nicholasshort/Tempting/PCB.jpg

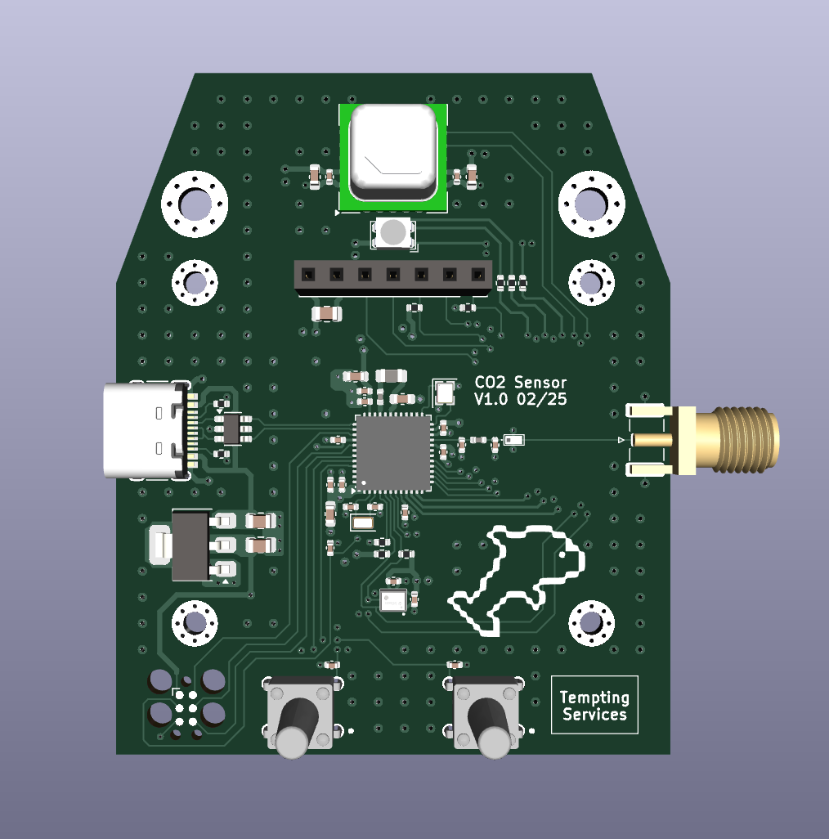
PCB.jpg
