nicholasshort/Tempting/Enclosure.jpg

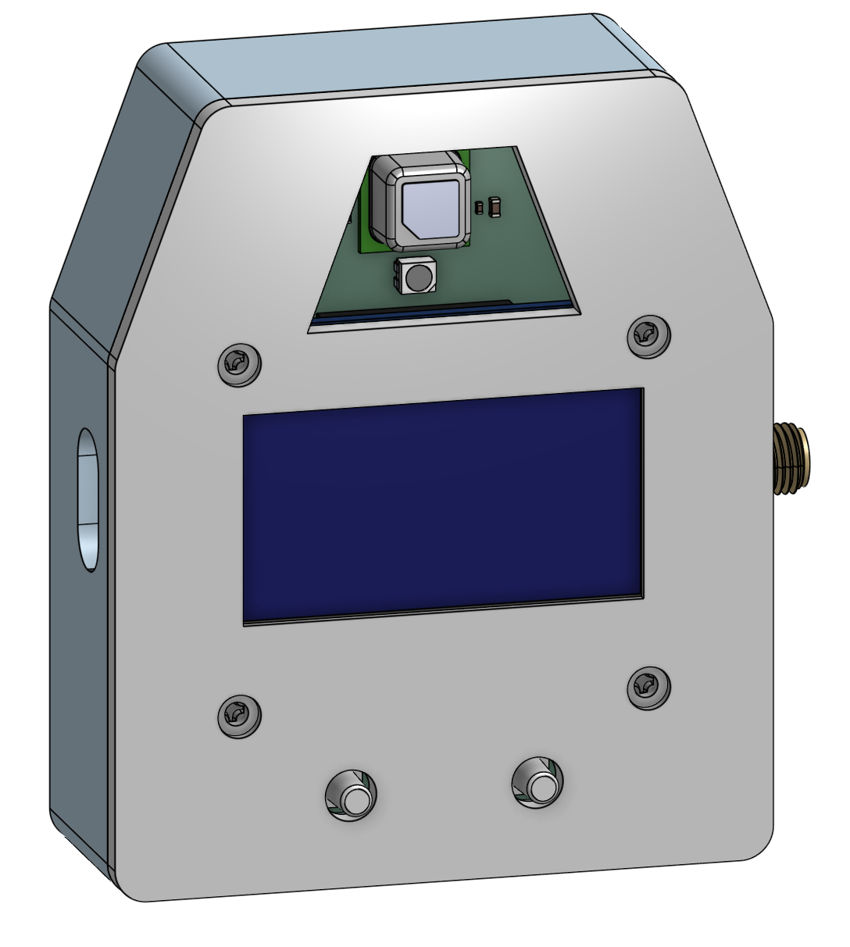
Enclosure.jpg
