nicholasshort/Tempting/TemptingPCB/Tempting.step

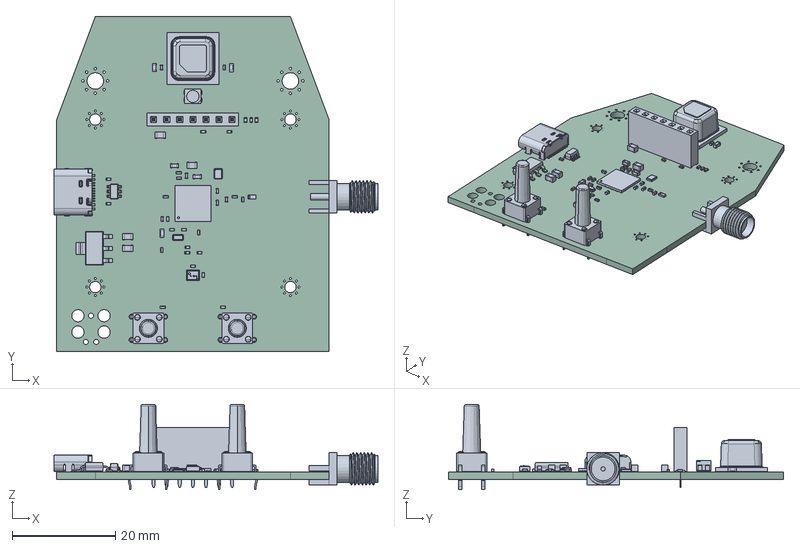
[picture p3: CAD file, 2025-06-16]
TemptingPCB/Tempting.step
62.8 x 65.0 x 16.5 mm
R_0402_1005Metric x 10
C_0402_1005Metric x 19
2-1825910-7-c-3d x 2
ConPins
PcbPins
Mold
Frame
C_0603_1608Metric x 5
SMA_Samtec_SMA-J-P-H-ST-EM1_EdgeMount
SCD41-D-R2
L_0402_1005Metric x 2
DLF162500LT-5028A1--3DModel-STEP-269445
SOT-23-6
PG-VLGA-8-2_Z8B00187549_V01_3D
L_0805_2012Metric
SOT-223
NX2012SA-32.768K-STD-MUB-1--3DModel-STEP-510211
PinSocket_1x07_P2.54mm_Vertical
CX2016DB32000D0WZRC1_CX2016DB32000D0WZRC1
C_0805_2012Metric x 3
STM32WB55CGU6
AAA3528LSEEZGKQBKS
Tempting_PCB
