nicholasshort/Tempting/TemptingPCB/Tempting_3D_Models/1_54inch-oled-module_sku25512.stp

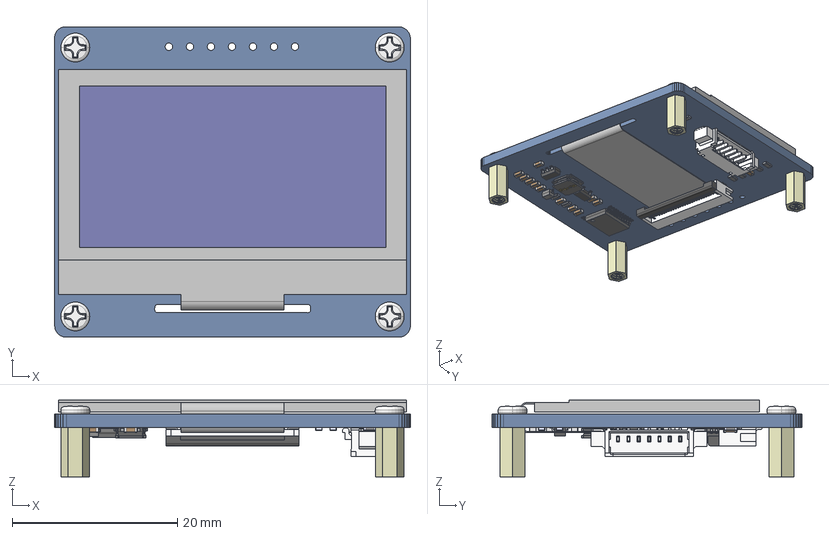
[picture p4: CAD file, 2025-05-03]
TemptingPCB/Tempting_3D_Models/1_54inch-oled-module_sku25512.stp
43.0 x 37.5 x 9.30 mm
BOARD
SW3DPS-SOT-23-5-DEFAULT x 2
USER_LIBRARY-TSSOP-20-2__-11558
USER_LIBRARY-TSSOP-20-2__-12509
USER_LIBRARY-TSSOP-20-2__-127_1 x 10
USER_LIBRARY-TSSOP-20-2__-127_2 x 10
RESC1608_0603_ x 8
HEADER-FPC-ZIF-SMD-HORIZO-17229
HEADER-FPC-ZIF-SMD-HORIZO-79148
USER_LIBRARY-INDLQS_4012_-80506
USER_LIBRARY-INDLQS_4012_-91143 x 2
USER_LIBRARY-INDLQS_4012_-91655
USER_LIBRARY-1N4148WS
CAPC1608_0603_ x 12
1_54INCH-128X64-QLED
HP1_25MM-1X7PIN-SMT
HEX_STUDS-M2XH6 x 4
PM2X5-SCREW x 4
