nicholasshort/Tempting/TemptingPCB/Tempting_3D_Models/HRO_TYPE-C-31-M-12.step

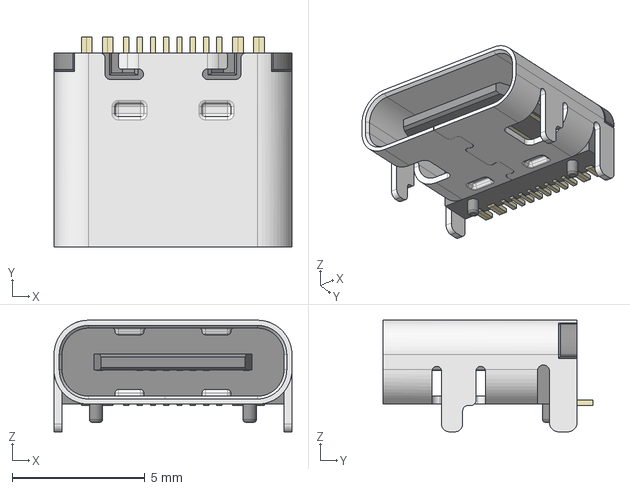
[picture p5: CAD file, 2025-02-19]
TemptingPCB/Tempting_3D_Models/HRO_TYPE-C-31-M-12.step
8.95 x 7.90 x 4.20 mm
