nicholasshort/Tempting/TemptingPCB/Tempting_3D_Models/SCD41-D-R2.STEP

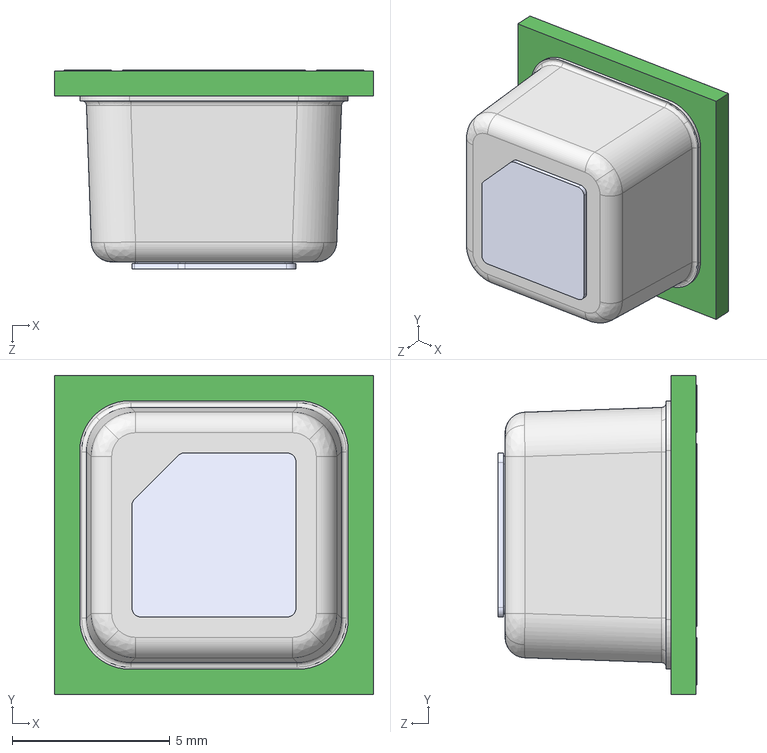
[picture p6: CAD file, 2025-02-19]
TemptingPCB/Tempting_3D_Models/SCD41-D-R2.STEP
10.1 x 10.1 x 6.31 mm
