nicholasshort/Tempting/TemptingPCB/Tempting_3D_Models/STM32WB55CGU6.step

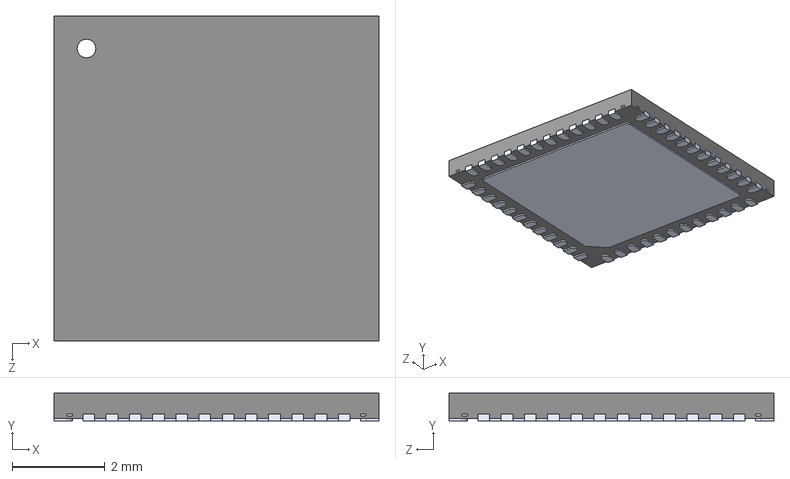
[picture p7: CAD file, 2025-02-19]
TemptingPCB/Tempting_3D_Models/STM32WB55CGU6.step
7.00 x 0.6 x 7.00 mm
