nicholasshort/Tempting/TemptingPCB/Tempting_3D_Models/AAA3528LSEEZGKQBKS.step

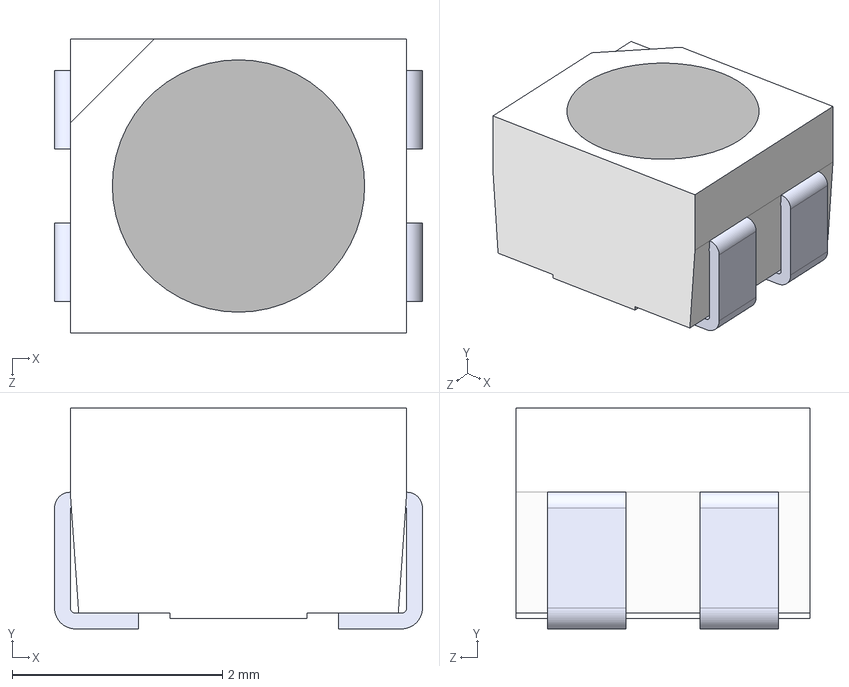
[picture p8: CAD file, 2025-02-19]
TemptingPCB/Tempting_3D_Models/AAA3528LSEEZGKQBKS.step
3.50 x 2.10 x 2.80 mm
