nicholasshort/Tempting/TemptingPCB/Tempting_3D_Models/CX2016DB16000D0WZRC1.STEP

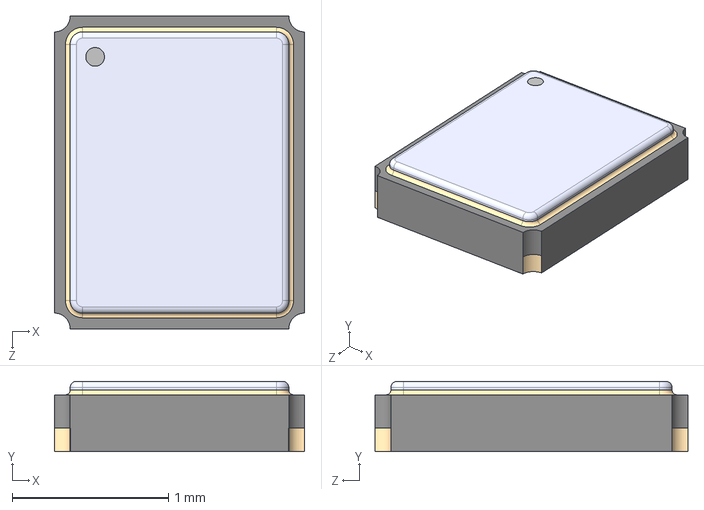
[picture p9: CAD file, 2025-02-19]
TemptingPCB/Tempting_3D_Models/CX2016DB16000D0WZRC1.STEP
1.60 x 0.45 x 2.00 mm
