nicholasshort/Tempting/TemptingPCB/Tempting_3D_Models/PG-VLGA-8-2_Z8B00187549_V01_3D.stp

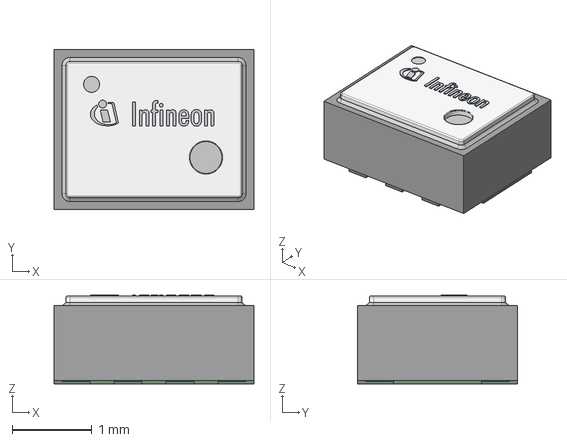
[picture p10: CAD file, 2025-02-19]
TemptingPCB/Tempting_3D_Models/PG-VLGA-8-2_Z8B00187549_V01_3D.stp
2.50 x 2.00 x 1.11 mm
