nicholasshort/Tempting/TemptingPCB/Tempting_3D_Models/2-1825910-7-c-3d.stp

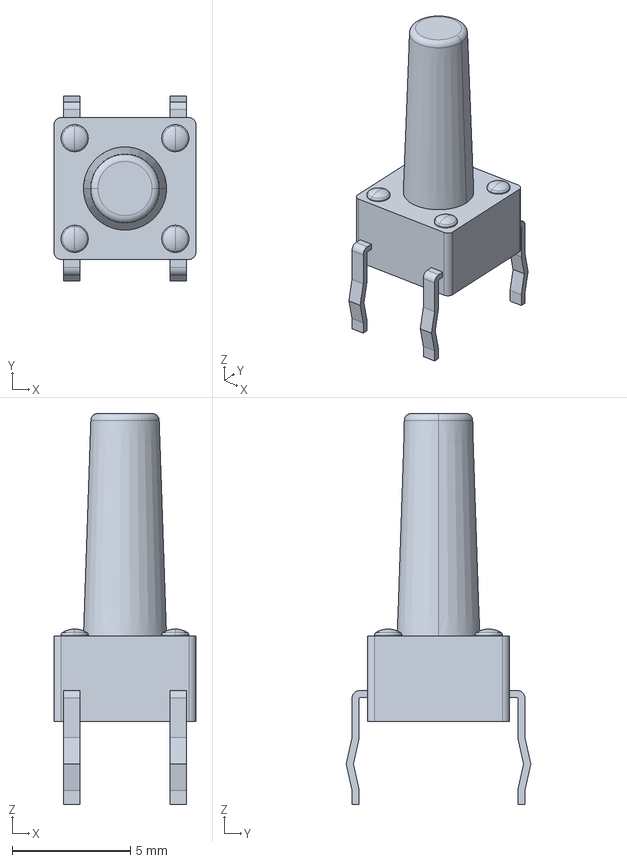
[picture p11: CAD file, 2025-02-19]
TemptingPCB/Tempting_3D_Models/2-1825910-7-c-3d.stp
5.99 x 7.80 x 16.5 mm
