nicholasshort/Tempting/TemptingPCB/Tempting_3D_Models/NX2012SA-32.768K-STD-MUB-1--3DModel-STEP-510211.STEP

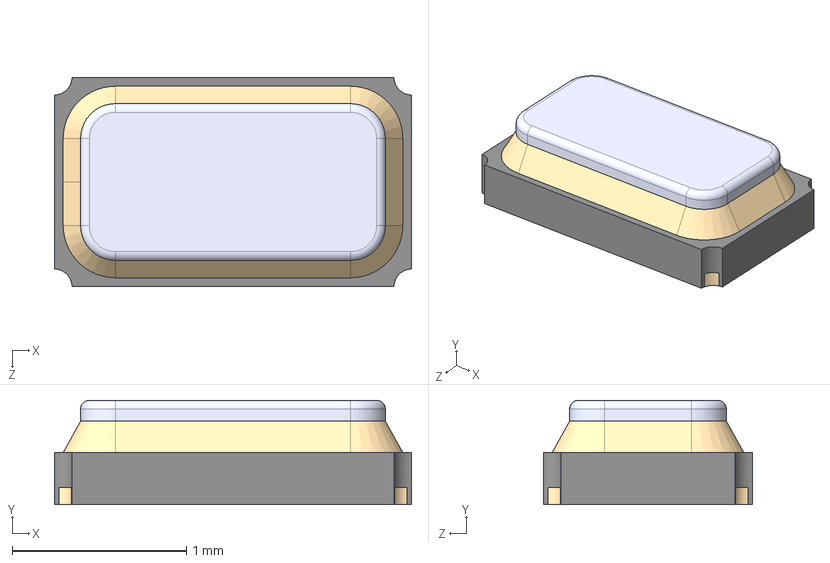
[picture p12: CAD file, 2025-02-19]
TemptingPCB/Tempting_3D_Models/NX2012SA-32.768K-STD-MUB-1--3DModel-STEP-510211.STEP
2.05 x 0.6 x 1.20 mm
