nicholasshort/Tempting/TemptingPCB/Tempting_3D_Models/DLF162500LT-5028A1--3DModel-STEP-269445.STEP

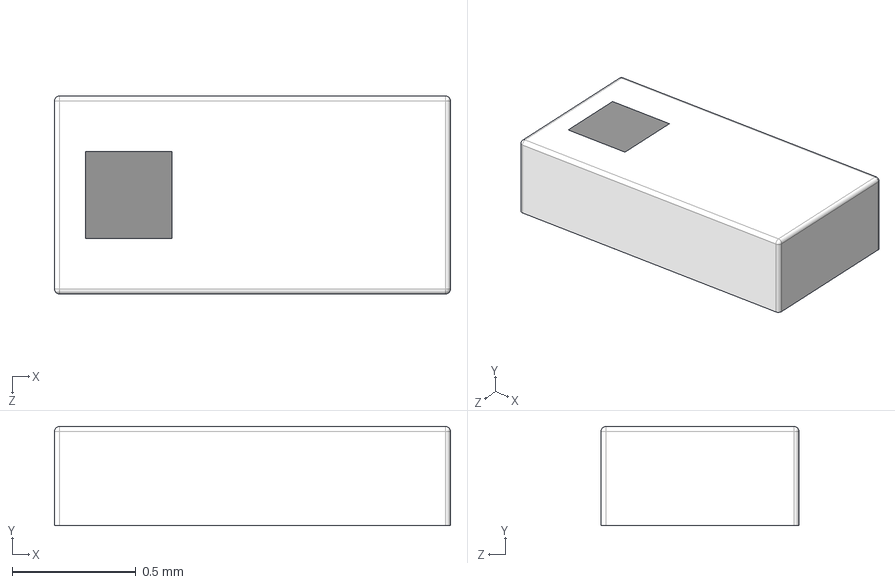
[picture p13: CAD file, 2025-02-19]
TemptingPCB/Tempting_3D_Models/DLF162500LT-5028A1--3DModel-STEP-269445.STEP
1.60 x 0.4 x 0.8 mm
