nicholasshort/Tempting/TemptingPCB/Tempting.kicad_pcb

## KiCad design TemptingPCB/Tempting.kicad_pcb (2025-02-28)

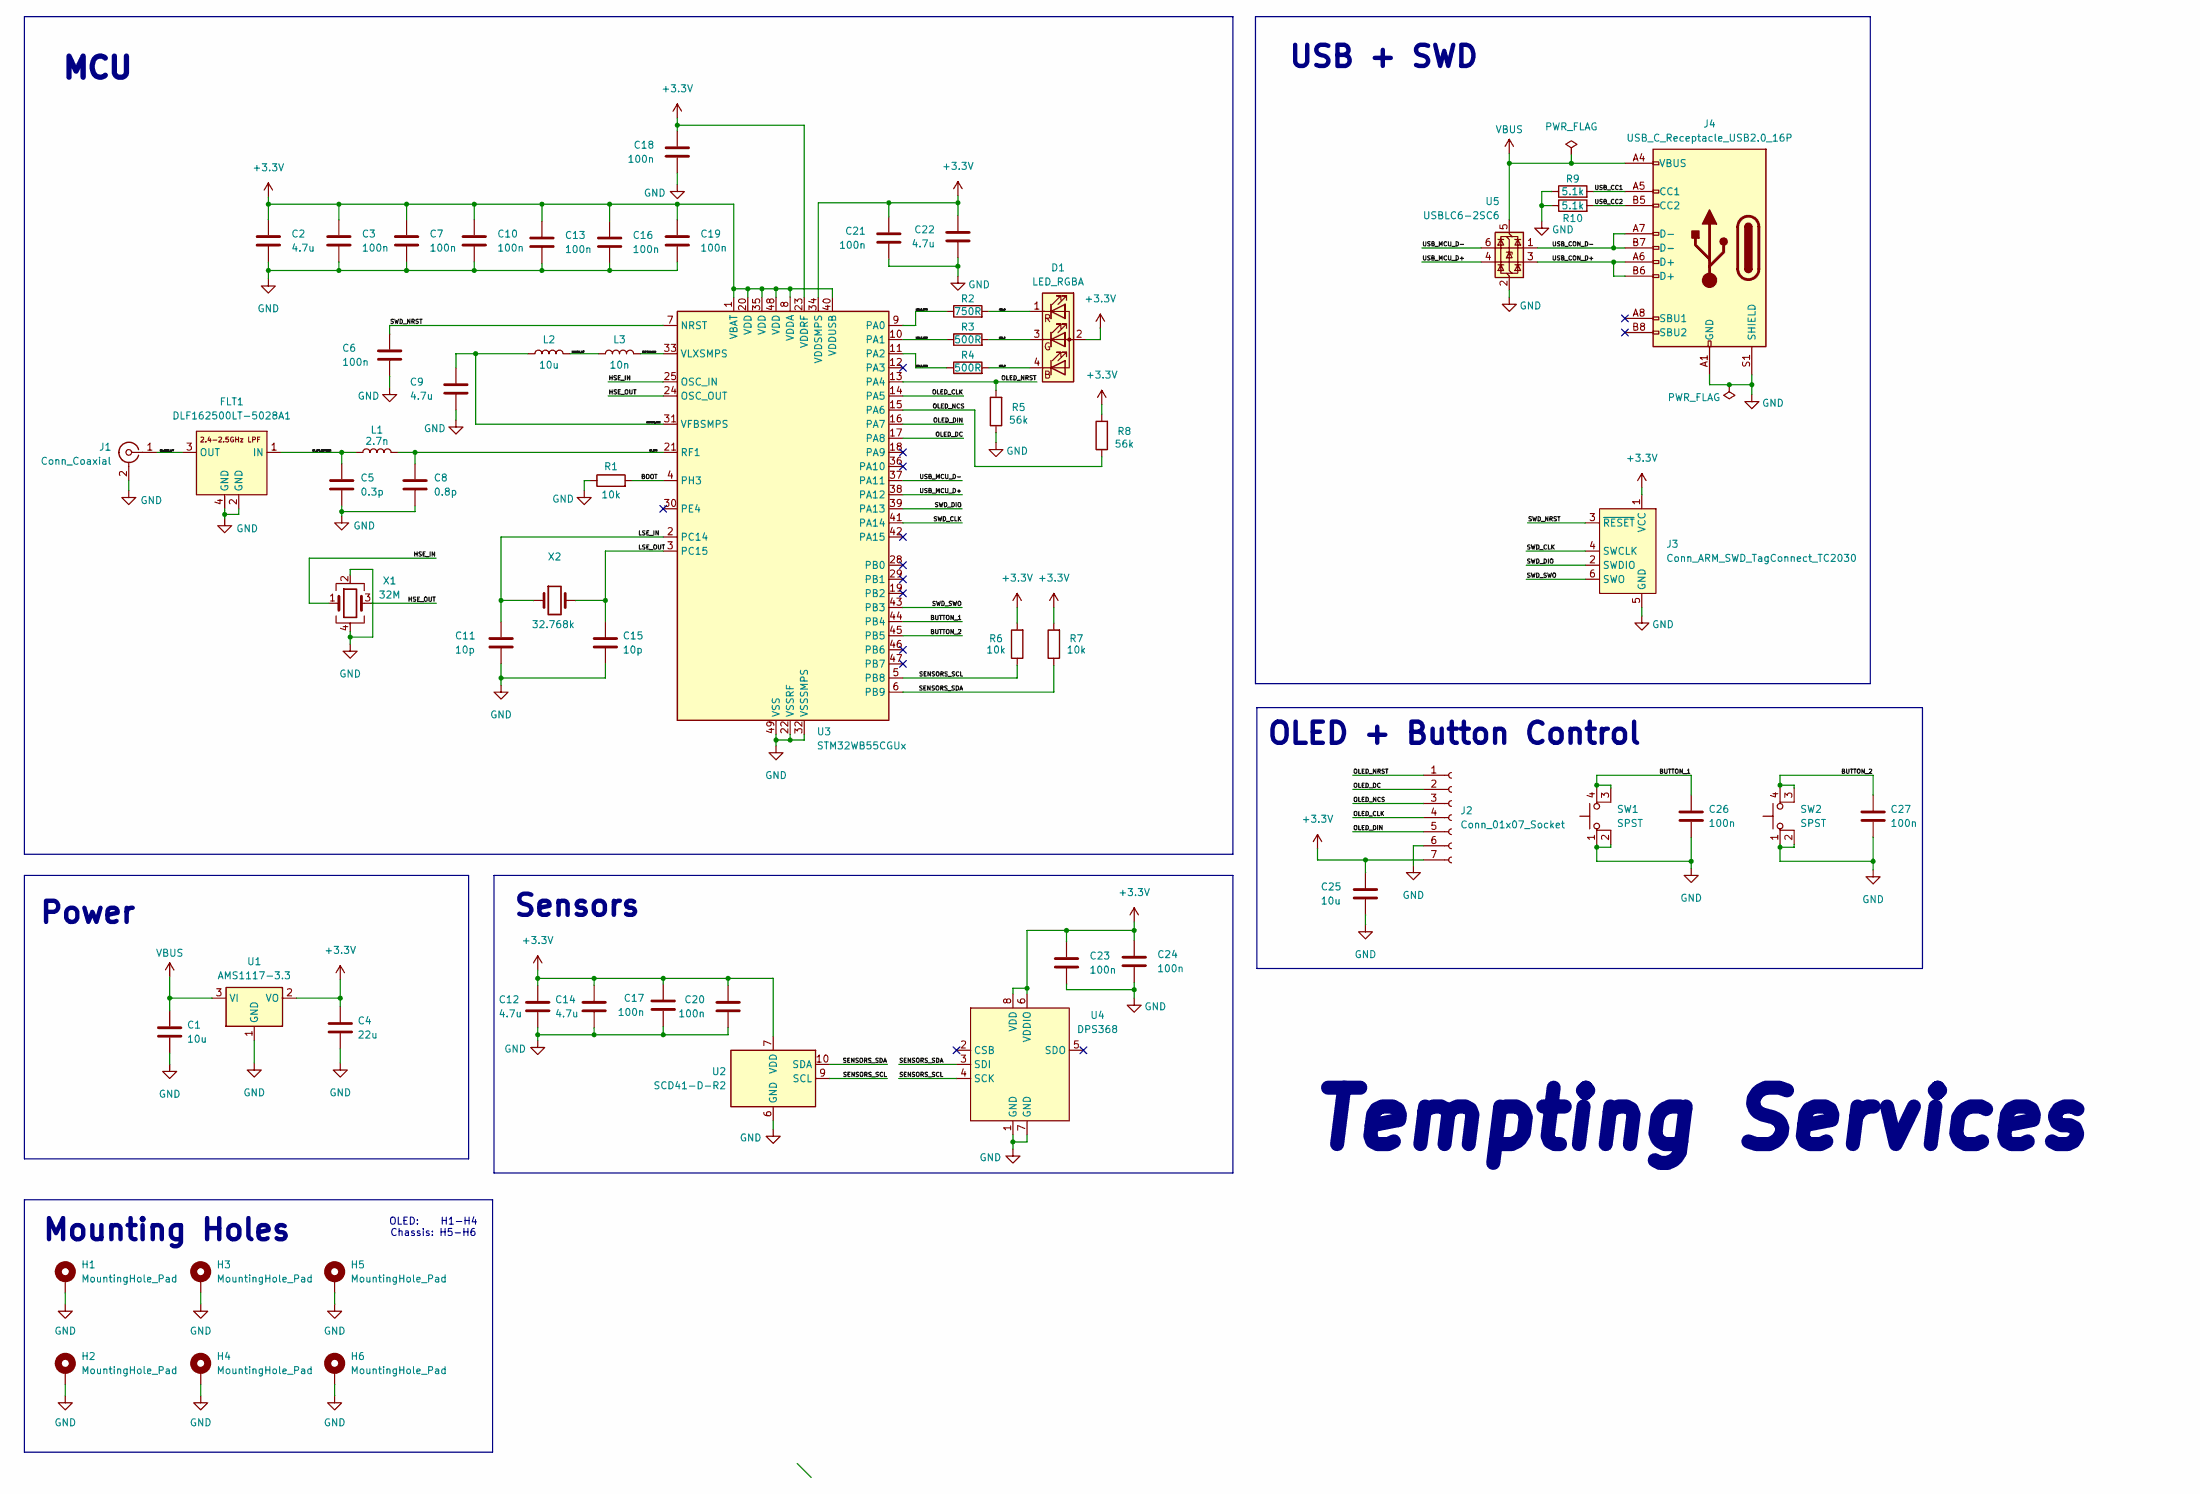
[picture p14: schematic Tempting.kicad_sch]

Parts:
C1, C25: 10u; C_0805_2012Metric; JLCPCB Part # C15850
C2, C9, C12, C14, C22: 4.7u; C_0603_1608Metric; JLCPCB Part # C1705
C3, C6, C7, C10, C13, C16, C17, C18, C19, C20, C21, C23, C24, C26, C27: 100n; C_0402_1005Metric; JLCPCB Part # C1525
C4: 22u; C_0805_2012Metric; JLCPCB Part # C29277
C5: 0.3p; C_0402_1005Metric; JLCPCB Part # C880415
C8: 0.8p; C_0402_1005Metric; JLCPCB Part # C76915
C11, C15: 10p; C_0402_1005Metric; JLCPCB Part # C161145
D1: LED_RGBA; AAA3528LSEEZGKQBKS; JLCPCB Part # C5547384
FLT1: DLF162500LT-5028A1; JLCPCB Part # C531364
H1, H2, H3, H4: MountingHole_Pad; MountingHole_2.2mm_M2_Pad_Via
H5, H6: MountingHole_Pad; MountingHole_3.2mm_M3_Pad_Via
J1: Conn_Coaxial; SMA_Samtec_SMA-J-P-H-ST-EM1_EdgeMount; JLCPCB Part # C5199907
J2: Conn_01x07_Socket; PinSocket_1x07_P2.54mm_Vertical
J3: Conn_ARM_SWD_TagConnect_TC2030; Tag-Connect_TC2030-IDC-FP_2x03_P1.27mm_Vertical
J4: USB_C_Receptacle_USB2.0_16P; USB_C_Receptacle_HRO_TYPE-C-31-M-12; JLCPCB Part # C165948
L1: 2.7n; L_0402_1005Metric; JLCPCB Part # C77108
L2: 10u; L_0805_2012Metric; JLCPCB Part # C98030
L3: 10n; L_0402_1005Metric; JLCPCB Part # C76760
R1, R6, R7: 10k; R_0402_1005Metric; JLCPCB Part # C25744
R2: 750R; R_0402_1005Metric; JLCPCB Part # C25132
R3, R4: 500R; R_0402_1005Metric; JLCPCB Part # C4125
R5, R8: 56k; R_0402_1005Metric; JLCPCB Part # C25796
R9, R10: 5.1k; R_0402_1005Metric; JLCPCB Part # C25905
SW1, SW2: SPST; 2-1825910-7; JLCPCB Part # C513492
U1: AMS1117-3.3; SOT-223-3_TabPin2; JLCPCB Part # C6186
U2: SCD41-D-R2; Sensirion_SCD4x-1EP_10.1x10.1mm_P1.25mm_EP4.8x4.8mm; JLCPCB Part # C3659362
U3: STM32WB55CGUx; QFN-48-1EP_7x7mm_P0.5mm_EP5.6x5.6mm; JLCPCB Part # C404023
U4: DPS368; JLCPCB Part # C3232508
U5: USBLC6-2SC6; SOT-23-6; JLCPCB Part # C7519
X1: 32M; Crystal_SMD_2016-4Pin_2.0x1.6mm; JLCPCB Part # C1986260
X2: 32.768k; Crystal_SMD_2012-2Pin_2.0x1.2mm; JLCPCB Part # C528982

Connections:
+3.3V: C2.1, C3.1, C4.1, C7.1, C10.1, C12.1, C13.1, C14.1, C16.1, C17.1, C18.1, C19.1, C20.1, C21.1, C22.1, C23.1, C24.1, C25.1, D1.2 (A), J2.7, J3.1 (VCC), R6.2, R7.2, R8.2, U1.2 (VO), U2.7 (VDD), U2.19 (VDD), U3.1 (VBAT), U3.8 (VDDA), U3.20 (VDD), U3.23 (VDDRF), U3.34 (VDDSMPS), U3.35 (VDD), U3.40 (VDDUSB), U3.48 (VDD), U4.6 (VDDIO), U4.8 (VDD)
/BOOT: R1.2, U3.4 (PH3)
/BUTTON_1: C26.1, SW1.3 (K), SW1.4 (A), U3.44 (PB4)
/BUTTON_2: C27.1, SW2.3 (K), SW2.4 (A), U3.45 (PB5)
/HSE_IN: U3.25 (OSC_IN), X1.1
/HSE_OUT: U3.24 (OSC_OUT), X1.3
/LED_B: D1.4 (BK), R4.2
/LED_B_MCU: R4.1, U3.11 (PA2)
/LED_G: D1.3 (GK), R3.2
/LED_G_MCU: R3.1, U3.10 (PA1)
/LED_R: D1.1 (RK), R2.2
/LED_R_MCU: R2.1, U3.9 (PA0)
/LSE_IN: C11.1, U3.2 (PC14), X2.1
/LSE_OUT: C15.1, U3.3 (PC15), X2.2
/OLED_CLK: J2.4, U3.14 (PA5)
/OLED_DC: J2.2, U3.17 (PA8)
/OLED_DIN: J2.5, U3.16 (PA7)
/OLED_NCS: J2.3, R8.1, U3.15 (PA6)
/OLED_NRST: J2.1, R5.2, U3.13 (PA4)
/RF_COAX_LPF: FLT1.3 (OUT), J1.1 (In)
/RF_LPF_MATCHING: C5.1, FLT1.1 (IN), L1.1
/RF_MCU: C8.1, L1.2, U3.21 (RF1)
/SENSORS_SCL: R6.1, U2.9 (SCL), U3.5 (PB8), U4.4 (SCK)
/SENSORS_SDA: R7.1, U2.10 (SDA), U3.6 (PB9), U4.3 (SDI)
/SMPSFB_MCU: C9.1, L2.1, U3.31 (VFBSMPS)
/SMPSLX_INT: L2.2, L3.1
/SMPSLX_MCU: L3.2, U3.33 (VLXSMPS)
/SWD_CLK: J3.4 (SWCLK), U3.41 (PA14)
/SWD_DIO: J3.2 (SWDIO), U3.39 (PA13)
/SWD_NRST: C6.1, J3.3 (~RESET), U3.7 (NRST)
/SWD_SWO: J3.6 (SWO), U3.43 (PB3)
/USB_CC1: J4.A5 (CC1), R9.2
/USB_CC2: J4.B5 (CC2), R10.2
/USB_CON_D+: J4.A6 (D+), J4.B6 (D+), U5.3 (I/O2)
/USB_CON_D-: J4.A7 (D-), J4.B7 (D-), U5.1 (I/O1)
/USB_MCU_D+: U3.38 (PA12), U5.4 (I/O2)
/USB_MCU_D-: U3.37 (PA11), U5.6 (I/O1)
GND: C1.2, C2.2, C3.2, C4.2, C5.2, C6.2, C7.2, C8.2, C9.2, C10.2, C11.2, C12.2, C13.2, C14.2, C15.2, C16.2, C17.2, C18.2, C19.2, C20.2, C21.2, C22.2, C23.2, C24.2, C25.2, C26.2, C27.2, FLT1.2 (GND), FLT1.4 (GND), H1.1, H2.1, H3.1, H4.1, H5.1, H6.1, J1.2 (Ext), J2.6, J3.5 (GND), J4.A1 (GND), J4.A12 (GND), J4.B1 (GND), J4.B12 (GND), J4.S1 (SHIELD), R1.1, R5.1, R9.1, R10.1, SW1.1, SW1.2, SW2.1, SW2.2, U1.1 (GND), U2.6 (GND), U2.20 (GND), U2.21 (GND), U3.22 (VSSRF), U3.32 (VSSSMPS), U3.49 (VSS), U4.1 (GND), U4.7 (GND), U5.2 (GND), X1.2, X1.4
VBUS: C1.1, J4.A4 (VBUS), J4.A9 (VBUS), J4.B4 (VBUS), J4.B9 (VBUS), U1.3 (VI), U5.5 (VBUS)

Notes on the sheet:
Tempting Services
MCU
USB + SWD
Mounting Holes
Power
Sensors
OLED + Button Control
OLED: H1-H4 Chassis: H5-H6

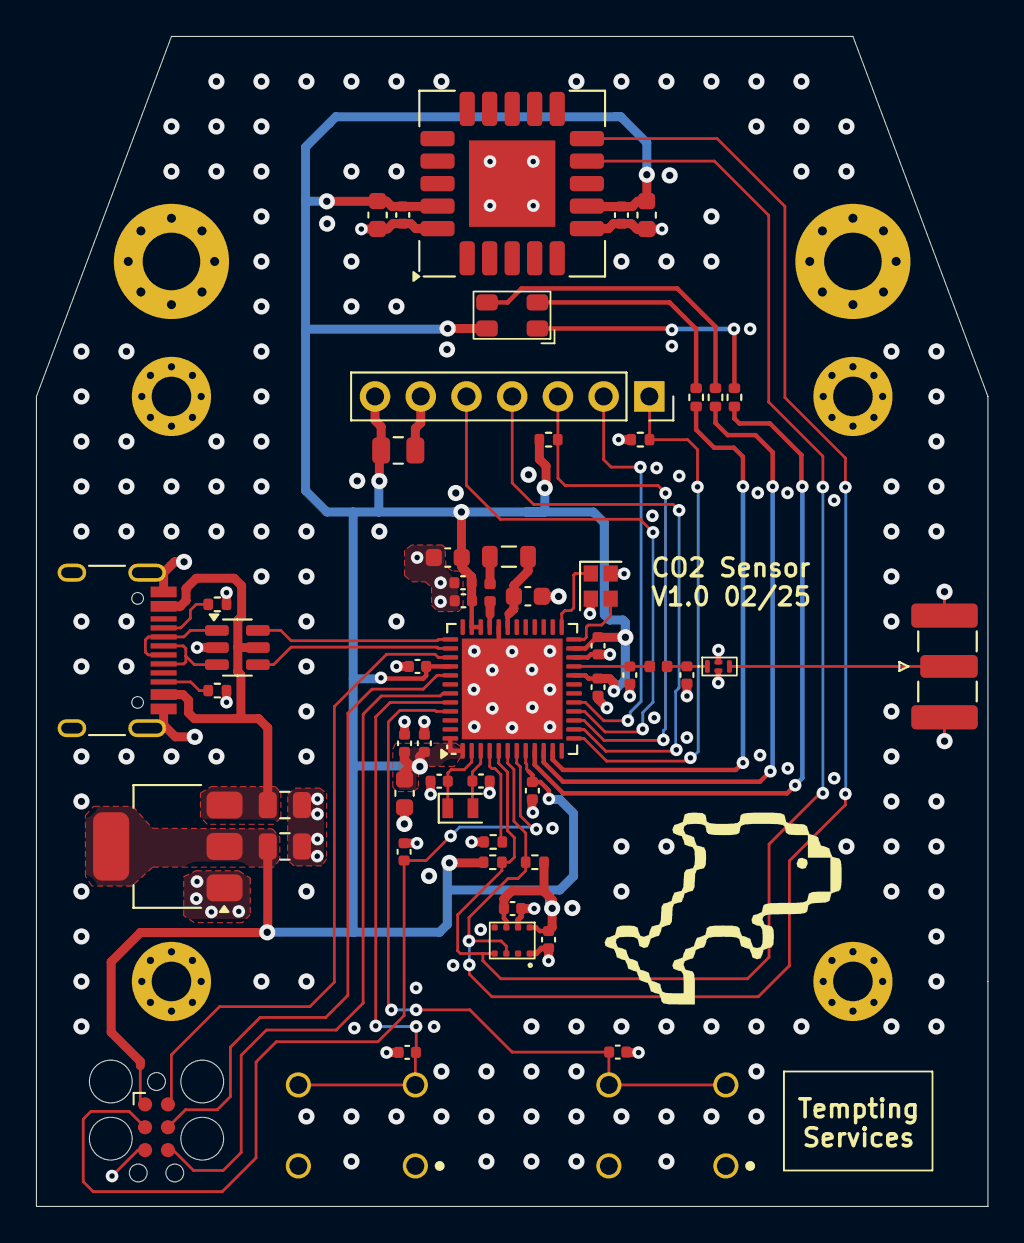
[picture p15: board Tempting.kicad_pcb from above]

Board: 4 copper layers, 52.9 x 65.0 mm, 61 parts (0 on the bottom side), 39 nets.
