nicholasshort/Tempting/TemptingFirmware/Core/Src/main.c

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
/* Includes ------------------------------------------------------------------*/
#include "main.h"
#include "i2c.h"
#include "ipcc.h"
#include "memorymap.h"
#include "rf.h"
#include "rtc.h"
#include "spi.h"
#include "tim.h"
#include "usb_device.h"
#include "gpio.h"

/* USER CODE BEGIN Includes */
#include "DPS368-Barometer.h"
#include "SCD41-CO2Sensor.h"
#include "SSD1309-OLED.h"
#include "RGB_LED.h"
#include "usbd_cdc_if.h"
/* USER CODE END Includes */


void SystemClock_Config(void);
void PeriphCommonClock_Config(void);
/* USER CODE BEGIN 0 */
int _write(int file, char *ptr, int len)
{
    while (CDC_Transmit_FS((uint8_t *)ptr, len) == USBD_BUSY) {
        // Optional: delay or yield to avoid USB deadlock
    }
    return len;
}
/* USER CODE END 0 */

/**
  * @brief  The application entry point.
  * @retval int
  */
int main(void)
{

  /* MCU Configuration--------------------------------------------------------*/

  /* Reset of all peripherals, Initializes the Flash interface and the Systick. */
  HAL_Init();
  /* Config code for STM32_WPAN (HSE Tuning must be done before system clock configuration) */
  MX_APPE_Config();

  /* Configure the system clock */
  SystemClock_Config();

  /* Configure the peripherals common clocks */
  PeriphCommonClock_Config();

  /* IPCC initialisation */
  MX_IPCC_Init();

  /* Initialize all configured peripherals */
  MX_GPIO_Init();
  MX_I2C1_Init();
  MX_SPI1_Init();
  MX_TIM2_Init();
  MX_RTC_Init();
  MX_USB_Device_Init();
  MX_RF_Init();
  /* USER CODE BEGIN 2 */
  RGB_LED_Init();
  RGB_LED_Set_Intensity(RGB_LED_RED_MAX_INTENSITY,0,0);

  DPS368_Init();
  SSD1309_Init();
  SCD41_StopPeriodicMeasurement();
  SCD41_StartPeriodicMeasurement();
  /* USER CODE END 2 */

  /* Init code for STM32_WPAN */
  MX_APPE_Init();

  /* Infinite loop */
  /* USER CODE BEGIN WHILE */

  while (1)
  {
    /* USER CODE END WHILE */
    MX_APPE_Process();

    /* USER CODE BEGIN 3 */
  }
  /* USER CODE END 3 */
}

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
