nicholasshort/Tempting/TemptingFirmware/TemptingFirmware.ioc

Mcu.UserName=STM32WB55CGUx
PA0.Signal=S_TIM2_CH1
PA1.Signal=S_TIM2_CH2
PA11.Signal=USB_DM
PA12.Signal=USB_DP
PA13.Signal=SYS_JTMS-SWDIO
PA14.Signal=SYS_JTCK-SWCLK
PA2.Signal=S_TIM2_CH3
PA4.GPIO_Label=OLED_NRST
PA4.Signal=GPIO_Output
PA5.Signal=SPI1_SCK
PA6.GPIO_Label=OLED_NCS
PA6.Signal=GPIO_Output
PA7.Signal=SPI1_MOSI
PA8.GPIO_Label=OLED_DC
PA8.Signal=GPIO_Output
PB3.Signal=SYS_JTDO-SWO
PB4.Signal=GPXTI4
PB5.Signal=GPXTI5
PB8.Signal=I2C1_SCL
PB9.Signal=I2C1_SDA
PC14-OSC32_IN.Signal=RCC_OSC32_IN
PC15-OSC32_OUT.Signal=RCC_OSC32_OUT
