nicholasshort/Tempting/TemptingFirmware/Core/Inc/main.h

#define OLED_NRST_Pin GPIO_PIN_4
#define OLED_NRST_GPIO_Port GPIOA
#define OLED_NCS_Pin GPIO_PIN_6
#define OLED_NCS_GPIO_Port GPIOA
#define OLED_DC_Pin GPIO_PIN_8
#define OLED_DC_GPIO_Port GPIOA
