nicholasshort/Tempting/(commit log)

2025-02-05 Added gitignore
    [Tempting.kicad_pcb, Tempting.kicad_sch]
2025-02-05 Added decouplign capacitors to schematic
    [Tempting.kicad_sch]
2025-02-05 Added crystals
    [Tempting.kicad_sch]
2025-02-07 Added RF circuitry to schematic
    [Tempting.kicad_sch]
2025-02-07 Added USB connector
    [Tempting.kicad_sch]
2025-02-07 Added LDO
    [Tempting.kicad_sch]
2025-02-07 Added OLED comm pins
    [Tempting.kicad_sch]
2025-02-07 Added circuitry for SCD41
    [Tempting.kicad_sch]
2025-02-12 Created symbol and footprint for DPS368
2025-02-12 Cleaned up and finished schematic
    [Tempting.kicad_sch]
2025-02-13 Added new footprints and assigned all footprints
    [Tempting.kicad_sch]
2025-02-13 Added all missing 3D models
    [Tempting.kicad_pcb]
2025-02-13 Added net classes
    [Tempting.kicad_pcb]
2025-02-13 Rough initial layout
    [Tempting.kicad_pcb, Tempting.kicad_sch]
2025-02-18 Added edge cuts and mounting holes
    [Tempting.kicad_pcb, Tempting.kicad_sch]
2025-02-18 Finetuned layout
    [Tempting.kicad_pcb, Tempting.kicad_sch]
2025-02-18 All signal traces routed
    [Tempting.kicad_pcb, Tempting.kicad_sch]
2025-02-19 Fixed DRC violations
    [Tempting.kicad_pcb]
2025-02-19 Assigned JLCPCB part numbers to all components
    [Tempting.kicad_sch]
2025-02-19 Commit before ordering on jlc
    [Tempting.kicad_pcb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]
2025-02-19 Adding manufacturing files
    [2-1825910-7-c-3d.stp, AAA3528LSEEZGKQBKS.step, CX2016DB16000D0WZRC1.STEP, DLF162500LT-5028A1--3DModel-STEP-269445.STEP, HRO_TYPE-C-31-M-12.step, NX2012SA-32.768K-STD-MUB-1--3DModel-STEP-510211.STEP, PG-VLGA-8-2_Z8B00187549_V01_3D.stp, SCD41-D-R2.STEP]
2025-02-27 Updated gerbers
    [Tempting-B_Cu.gbr, Tempting-B_Mask.gbr, Tempting-B_Paste.gbr, Tempting-B_Silkscreen.gbr, Tempting-Edge_Cuts.gbr, Tempting-F_Cu.gbr, Tempting-F_Mask.gbr, Tempting-F_Paste.gbr]
2025-02-28 Updated ufl connector to sma
    [Tempting.kicad_pcb, Tempting.kicad_sch]
2025-05-03 Commit before recreating TempFirmware in cubeide
    [1_54inch-oled-module_sku25512.stp, 2-1825910-7-c-3d.stp, AAA3528LSEEZGKQBKS.step, CX2016DB16000D0WZRC1.STEP, DLF162500LT-5028A1--3DModel-STEP-269445.STEP, HRO_TYPE-C-31-M-12.step, NX2012SA-32.768K-STD-MUB-1--3DModel-STEP-510211.STEP, PG-VLGA-8-2_Z8B00187549_V01_3D.stp]
2025-06-16 Added zigbee capabilities to Tempting
    [Tempting.step]
2025-06-18 Working temperature and pressure attribute table updates. Learned that HAL_Delay cannot be used within an HW_TS callback function
